zidou92/WinECG/CardECG/Hardware/cardecg.kicad_pcb

## KiCad design CardECG/Hardware/cardecg.kicad_pcb (2016-03-27)

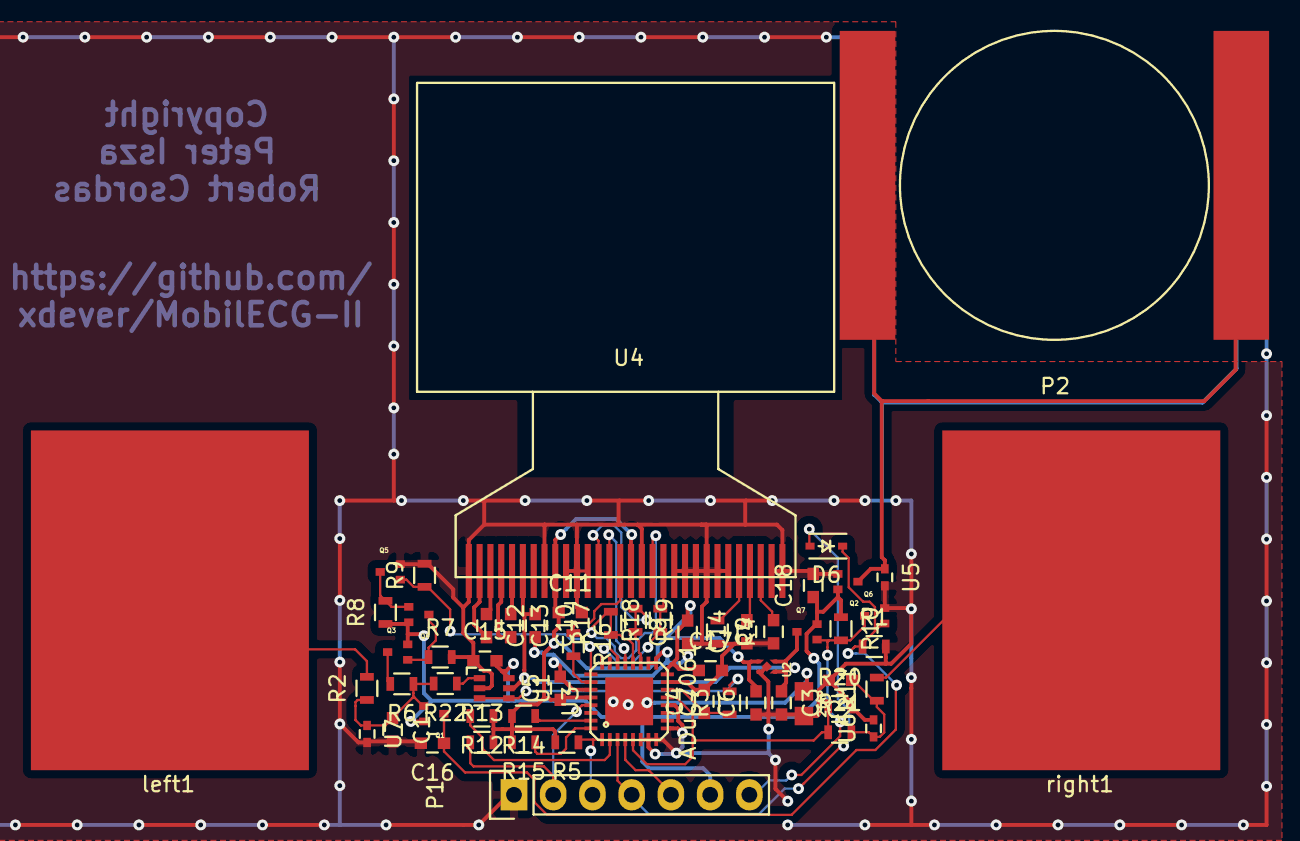
[picture p1: board cardecg.kicad_pcb from above]

Board: 2 copper layers, 59 parts (0 on the bottom side), 39 nets.

Parts:
C1: 100pF; C_0603
C2, C5, C8, C15, C16: 100nF; C_0603
C3, C6, C10, C11, C12, C13, C17, C18: 1uF; C_0603
C4: 8.2nF NP0; C_0603
C9: 2.2uF; C_0603
C14: 4.7uF 16V; C_0603
CN1: 2TAP
D6: D; SOD-323
P1: PROG; Pin_Header_Straight_1x07
P2: BATTERY; CR2016
Q1, Q2, Q3, Q4, Q7: NX3008PBKT; SOT416
Q5, Q6: NX3008NBKT; SOT416
R1, R2, R3, R5, R8, R9, R10, R11, R12, R14, R15, R20: 47k; R_0603
R4: 390k; R_0603
R6, R7: 10M; R_0603
R13, R21, R22: 3.9k; R_0603
R16, R17, R18, R19: 49; R_0603
U1: LMV341; SC-70-6
U2: LD6805K/25; DFN1010C-4
U3: ADuC7061; LFCSP_VQ_CP32-2
U4: SSD1306
U5, U6, U7: TPD1E10B06; C_0402
left1: CONN_1; ecgpad
right1: CONN_1; ecgpad

Connections:
+BATT: C15.2, C18.1, P1.6, Q1.2, Q2.2, Q3.2, Q4.2, Q7.2, R8.1, R10.1, U1.6
GND: C1.2, C2.2, C3.2, C4.2, C5.2, C6.1, C8.1, C9.1, C10.2, C11.2, C14.1, C15.1, C16.2, C17.2, C18.2, CN1.2, P1.1, P2.3, P2.4, Q2.1, Q5.2, Q6.2, R1.2, R4.2, R7.2, R9.2, R20.2, U1.2, U2.2, U2.PAD, U3.6, U3.7, U3.8, U3.9, U3.12, U3.15, U3.17, U3.18, U3.27, U4.1, U4.8, U4.10, U4.11, U4.12, U4.17, U4.20, U4.21, U4.22, U4.23, U4.24, U4.25, U4.29, U4.30, U5.2, U6.2, U7.2
unnamed: C1.1, Q1.1, R2.1, R6.1, R22.2, U7.1
unnamed: C2.1, R11.1, R21.2, U6.1
unnamed: C4.1, R3.1, U3.14
unnamed: C9.2, U4.28
unnamed: C12.1, U4.3
unnamed: C12.2, U4.2
unnamed: C13.1, U4.5
unnamed: C13.2, U4.4
unnamed: C14.2, U4.27
unnamed: C16.1, D6.1, Q1.3, Q6.1, R1.1
unnamed: CN1.1, U3.33
unnamed: P2.1, P2.2, Q2.3, U5.1
unnamed: Q3.1, Q4.3, R7.1
unnamed: Q3.3, R6.2
unnamed: Q4.1, Q5.3, R8.2
unnamed: R2.2, left1.1
unnamed: R3.2, U1.3, U1.4
unnamed: R4.1, U4.26
unnamed: R11.2, right1.1
unnamed: R12.2, U3.2
unnamed: R14.1, U3.31
unnamed: R15.1, U3.32
unnamed: R16.1, R16.2, U3.26, U4.15
unnamed: R17.1, R17.2, U3.20, U4.18
unnamed: R18.1, R18.2, U3.22, U4.19
unnamed: R19.1, R19.2, U3.19, U4.13
unnamed: R20.1, R21.1, U3.5, U3.13
unnamed: R22.1, U1.1
unnamed: U3.21, U4.14
PULLUP_OFF: Q5.1, R9.1, U3.25
RX/POWER_ON: D6.2, P1.4, U3.3
TX: P1.5, U3.4
VCC: C3.1, C10.1, Q7.3, U1.5, U2.3, U2.4, U4.6
VDD: C5.1, C6.2, C8.2, C11.1, C17.1, R5.2, R12.1, R13.2, R14.2, R15.2, U2.1, U3.16, U3.28, U4.9, U4.16
~FORCE_ON: P1.7, Q6.3, Q7.1, R10.2
~PROG: P1.2, R13.1, U3.29
~RESET: P1.3, R5.1, U3.1
