zidou92/WinECG/(commit log)

2016-02-26 Change TPS717 to TPS71725.
    [cardecg.sch]
2016-03-01 Battery holder improvements.
    [cardecg.kicad_pcb]
2016-03-03 CardECG PCB fixes.
    [cardecg.kicad_pcb, cardecg.sch]
2016-03-03 Bigger display cutout.
    [cardecg.kicad_pcb]
2016-03-05 Fix LDO footprint. Modify makefile for FTDI UART.
    [cardecg.kicad_pcb, cardecg.sch]
2016-03-05 Resistor value fixes/optimizations. EMC resistors on display.
    [cardecg.sch]
2016-03-06 EMC optimizations. Compoments rearranged to leave more space for the upper PCB.
    [cardecg.kicad_pcb, cardecg.sch]
2016-03-16 Change transistors to smaller package.
    [cardecg.kicad_pcb, cardecg.sch]
2016-03-16 Add filter cap, pulldown resistor, battery ESD protection.
    [cardecg.kicad_pcb, cardecg.sch]
2016-03-16 New LDO. Change display to 4 bit SPI. Remove unnecessary transistor and resistor.
    [cardecg.sch]
2016-03-27 Random modifications.
    [cardecg.kicad_pcb, cardecg.sch]
2016-03-28 Thin opamp and diode
2016-09-04 A bit more specific value for D6
    [cardecg.sch]
